nppc/UniversalDCBuckHW/Refs/Example.GIF

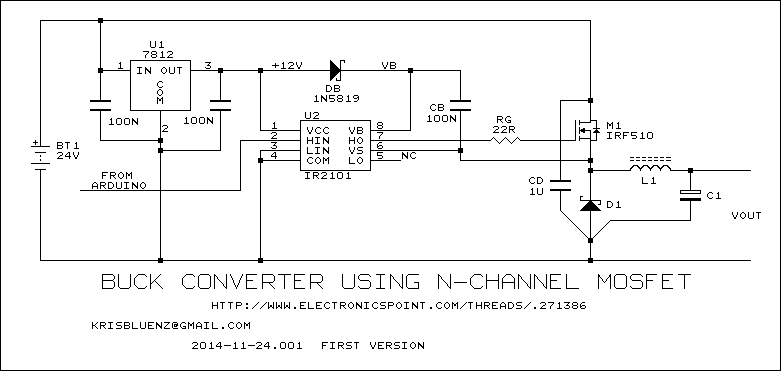
Refs/Example.GIF
