nppc/UniversalDCBuckHW/SCAD/PPS1045.scad

color("black")translate([0,0,1.1/2+0.05])cube([4,5.3, 1.1],true);
color("gray")translate([0,1-0.6,0.29/2])cube([3,3.3, 0.29],true);
color("gray")translate([0,1.15+0.6,0.29/2])cube([1.8,3, 0.29],true);
color("gray")translate([1.84/2,-2.2-0.6,0.29/2])cube([0.9,0.9, 0.29],true);
color("gray")translate([-1.84/2,-2.2-0.6,0.29/2])cube([0.9,0.9, 0.29],true);
