nppc/UniversalDCBuckHW/(list of files, cad)

Other CAD files:
Firmware/Assembler/UDCBuckHW/out/HWBuckAtTiny85/default.obj
