nppc/UniversalDCBuckHW/KiCad/Adapter1-25to1/Adapter1-25to1.kicad_pcb

## KiCad design KiCad/Adapter1-25to1/Adapter1-25to1.kicad_pcb (2020-04-30)

Schematic: Adapter1-25to1.sch

Parts:
J1: Conn_01x06_Male; Pads_prog_6pin1.25mm
J2: Conn_01x06; JST_SH_6x1mm
J3: Conn_01x06_Male; Pin_Header_Angled_1x06_Pitch1.27mm

Connections:
unnamed: J1.1, J2.1, J3.1
unnamed: J1.2, J2.2, J3.2
unnamed: J1.3, J2.3, J3.3
unnamed: J1.4, J2.4, J3.4
unnamed: J1.5, J2.5, J3.5
unnamed: J1.6, J2.6, J3.6

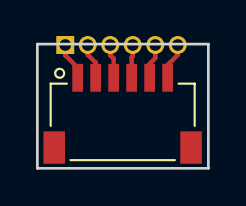
[picture p2: board Adapter1-25to1.kicad_pcb from above]

Board: 2 copper layers, 9.5 x 6.9 mm, 3 parts (1 on the bottom side), 6 nets.
