nppc/UniversalDCBuckHW/KiCad/UniDCBuckHW.kicad_pcb

## KiCad design KiCad/UniDCBuckHW.kicad_pcb (2018-08-07)

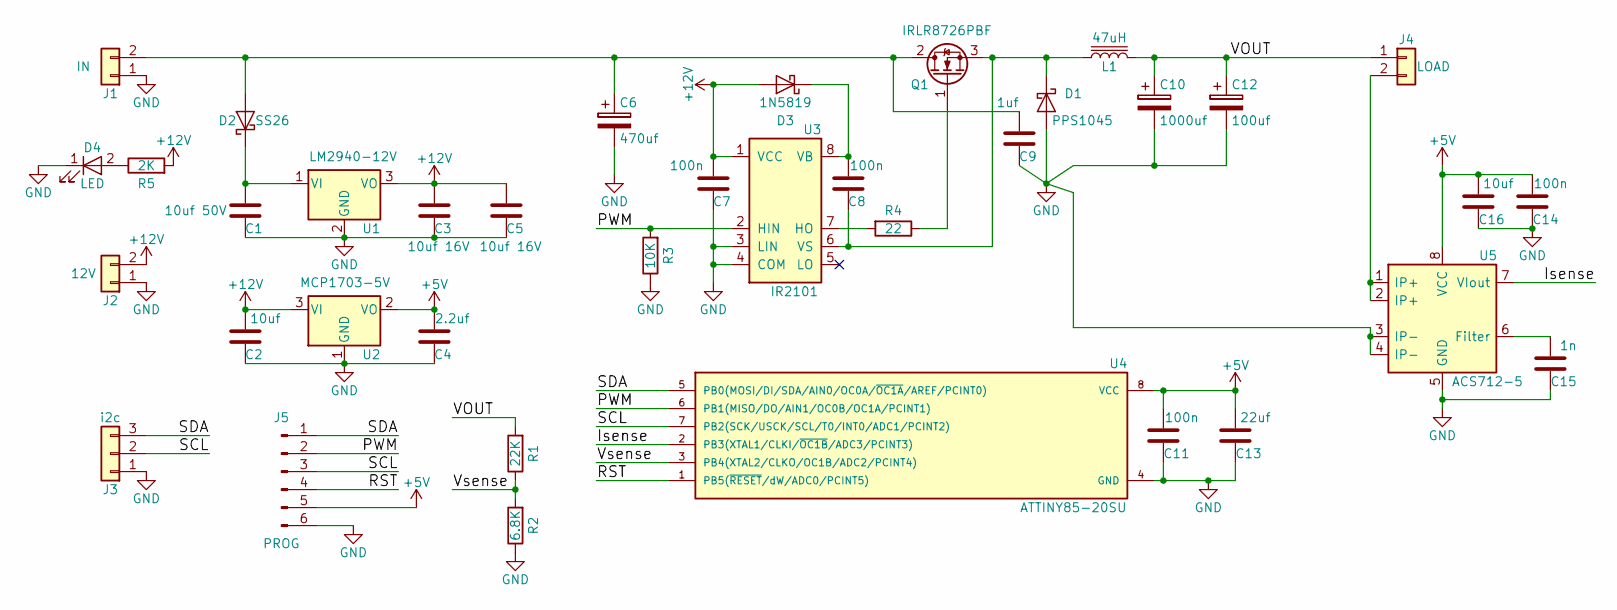
[picture p3: schematic UniDCBuckHW.sch]

Parts:
C1: 10uf 50V; C_0805
C2: 10uf; C_0805
C3, C5: 10uf 16V; C_0805
C4: 2.2uf; C_0805
C6: 470uf; CP_Radial_D10.0mm_P5.00mm
C7, C8, C11, C14: 100n; C_0603
C9: 1uf; C_0603
C10: 1000uf; CP_Radial_D12.5mm_P5.00mm
C12: 100uf; CP_Tantalum_Case-V_EIA-7343-20_Reflow
C13: 22uf; C_0805
C15: 1n; C_0603
C16: 10uf; C_0603
D1: PPS1045; D_Powermite3
D2: SS26; D_SMB
D3: 1N5819; D_SOD-523
D4: LED; LED_0805
J1: IN; Conn_Power
J2: 12V; Conn2pin_2.54mm
J3: i2c; Pin_Header_Straight_1x03_Pitch2.54mm
J4: LOAD; Conn_Power
J5: PROG; Pads_prog_6pin1.25mm
L1: 47uH; PCV-2-473-10L
Q1: IRLR8726PBF; TO-252-2_Rectifier
R1: 22K; R_0603
R2: 6.8K; R_0603
R3: 10K; R_0603
R4: 22; R_0603
R5: 2K; R_0603
U1: LM2940-12V; TO-263-3_TabPin2
U2: MCP1703-5V; SOT-23
U3: IR2101; SOIC-8_3.9x4.9mm_Pitch1.27mm
U4: ATTINY85-20SU; SOIJ-8_5.3x5.3mm_Pitch1.27mm
U5: ACS712-5; SOIC-8_3.9x4.9mm_Pitch1.27mm

Connections:
+5V: C4.2, C11.2, C13.2, C14.2, C16.2, J5.5, U2.2 (VO), U4.8 (VCC), U5.8 (VCC)
+12V: C2.2, C3.2, C5.2, C7.2, D3.2 (A), J2.2, R5.2, U1.3 (VO), U2.3 (VI), U3.1 (VCC)
/Isense: U4.2 (PB3(XTAL1/CLKI/~OC1B~/ADC3/PCINT3)), U5.7 (VIout)
/PWM: J5.2, R3.2, U3.2 (HIN), U4.6 (PB1(MISO/DO/AIN1/OC0B/OC1A/PCINT1))
/RST: J5.4, U4.1 (PB5(~RESET~/dW/ADC0/PCINT5))
/SCL: J3.2, J5.3, U4.7 (PB2(SCK/USCK/SCL/T0/INT0/ADC1/PCINT2))
/SDA: J3.3, J5.1, U4.5 (PB0(MOSI/DI/SDA/AIN0/OC0A/~OC1A~/AREF/P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)
/VOUT: C10.1, C12.1, J4.1, L1.2, R1.2
/Vsense: R1.1, R2.2, U4.3 (PB4(XTAL2/CLKO/OC1B/ADC2/PCINT4))
GND: C1.1, C2.1, C3.1, C4.1, C5.1, C6.2, C7.1, C9.1, C10.2, C11.1, C12.2, C13.1, C14.1, C15.1, C16.1, D1.2 (A), D4.1 (K), J1.1, J2.1, J3.1, J5.6, R2.1, R3.1, U1.2 (GND), U2.1 (GND), U3.3 (LIN), U3.4 (COM), U4.4 (GND), U5.3 (IP-), U5.4 (IP-), U5.5 (GND)
unnamed: C1.2, D2.1 (K), U1.1 (VI)
unnamed: C6.1, C9.2, D2.2 (A), J1.2, Q1.2 (D)
unnamed: C8.1, D1.1 (K), L1.1, Q1.3 (S), U3.6 (VS)
unnamed: C8.2, D3.1 (K), U3.8 (VB)
unnamed: C15.2, U5.6 (Filter)
unnamed: D4.2 (A), R5.1
unnamed: J4.2, U5.1 (IP+), U5.2 (IP+)
unnamed: Q1.1 (G), R4.1
unnamed: R4.2, U3.7 (HO)

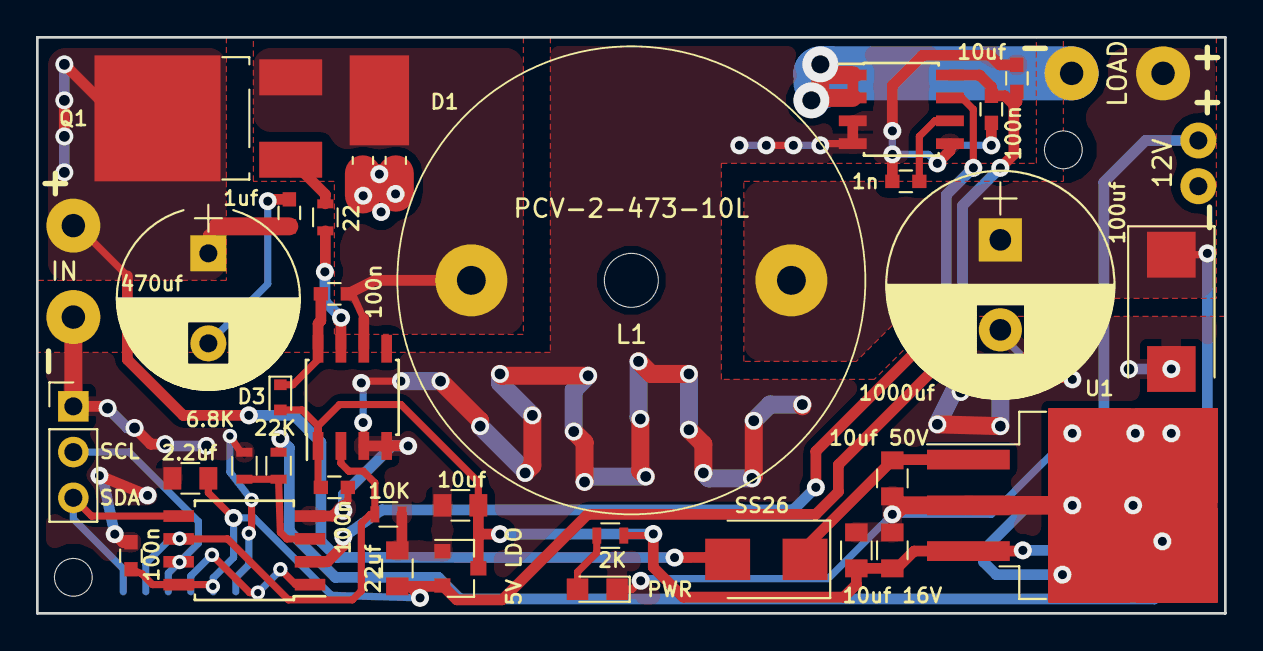
[picture p4: board UniDCBuckHW.kicad_pcb from above]

Board: 2 copper layers, 66.0 x 32.0 mm, 37 parts (1 on the bottom side), 19 nets.
