nppc/UniversalDCBuckHW/(threads)

Thread 2 (2018-09-02):

Seems Max limit for voltage set is not working

nppc, 2018-09-02:
I can set 125 and it regulates to 12.5V, where 120 is maximum.
