nppc/UniversalDCBuckHW/Firmware/Assembler/UDCBuckHW/main.c

/**
 * @file main.c
 * @author Pavel
 * @date 2026-10-11
 * @brief Main function
 */
int main(){

    // Add your code here and press Ctrl + Shift + B to build
    while(1) {
        
    }

    return 0;
}
