nppc/UniversalDCBuckHW/(commit log)

2018-08-02 3d part
    [PCV-2-473-10L.scad]
2018-08-03 Refs added. Initial KiCad
    [UniDCBuckHW.kicad_pcb, UniDCBuckHW.sch]
2018-08-05 Draft PCB is ready
    [PPS1045.scad]
2018-08-05 Final Vq PCB
    [UniDCBuckHW.kicad_pcb, UniDCBuckHW.sch]
2018-08-07 minor changes
    [UniDCBuckHW.kicad_pcb]
2018-08-13 Started to write I2C routines
2018-08-22 test i2c addr
2018-08-23 debug i2c
2018-08-23 i2c 90% completed
2018-08-24 still issues with i2c
    [main.asm]
2018-08-26 ADC and PWM routines started
2018-08-27 I2C working for receiving data
2018-08-28 I2C draft for sending data. Not tested
2018-08-28 I2C read/write working
2018-08-30 I2C exchange routines are finished
2018-08-30 Some progress on converting ADC values
2018-09-02 Needed to move ADC from interrupts to main code. Othervise I2C works unstable
    [main.asm]
2018-09-02 Cleanup and I reading error fix
    [main.asm]
2018-09-03 Check for max voltage
2018-09-04 Change SRAM variable to register. Performance in interrupt inmproved
2020-04-30 47/10 divider
    [Adapter1-25to1.kicad_pcb, Adapter1-25to1.sch, UniDCBuckHW-2019-04-27-19-16-52.sch, UniDCBuckHW.sch]
2026-10-11 Prevent Buffer Overflow in i2c
